Mqr1oo/GLYPH/.github/release/notes.md

## 🗺️ A detailed map of the whole world, and routes that go straight into GLYPH

### Download

**GLYPH-1.3.0.apk**: the Android app, for Android 7 or newer. Open it on your phone to install.

The app keeps itself up to date once it is installed. The GLYPH firmware (04.10.26) is inside it:
the app installs it over USB-C with the access code that comes with your GLYPH, and GLYPH then
updates itself over Wi-Fi from **Control › Firmware**.

### What's new

**Maps**
- A **detailed dark map of the whole world**: streets, hiking trails, forest tracks, peaks with their height, rivers, huts and borders.
- **Save area** keeps what you see for use with no signal. **Save for this route** keeps a 2 km band along your route.
- With no signal you still get a world map with towns, forests and borders.
- Places worldwide are found offline: every town and village with 500 people or more is built in.

**Routes**
- Bike and walking routes stay on land instead of taking a ferry.
- A smaller route panel that leaves the map in view.
- **Send to GLYPH** loads the route into the device's own memory, no card needed. The small card button saves it to the memory card only.

**Setup**
- **Install firmware over USB-C, straight from your phone**: the app's first screen, with your GLYPH access code. No computer, no internet.

**Look and feel**
- A cleaner Comms tab, a single "not connected" line in Control, the guided tour always on screen, and the map credits folded into a small **i**.

See the full [changelog](https://github.com/Mqr1oo/GLYPH/blob/main/CHANGELOG.md).

### Checksums

`SHA256SUMS.txt` lists the SHA-256 of every file in this release.
