Mqr1oo/GLYPH/docs/GLYPH-build-guide.pdf

# GLYPH

# Build guide

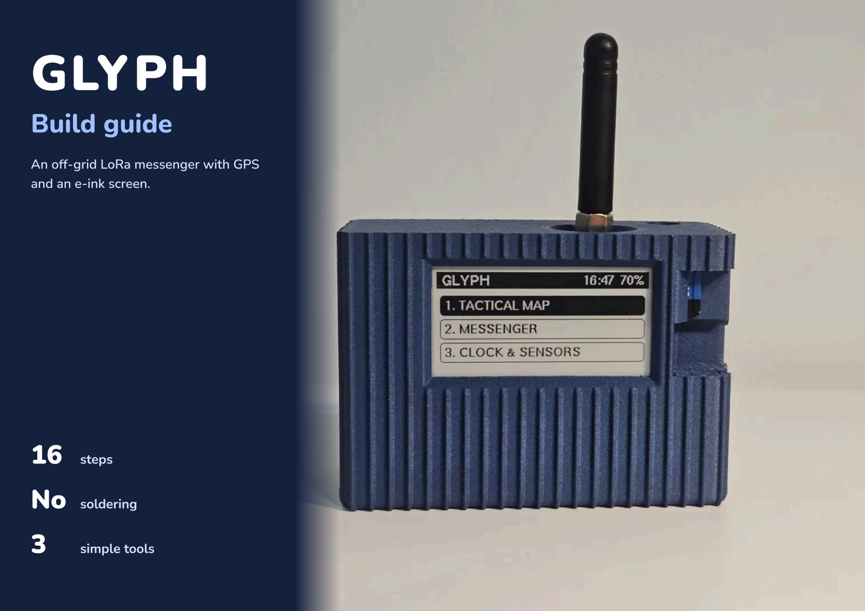
[picture p13: page 1]

An off-grid LoRa messenger with GPS and an e-ink screen.

16 steps

No soldering

3 simple tools

# ! Before you start

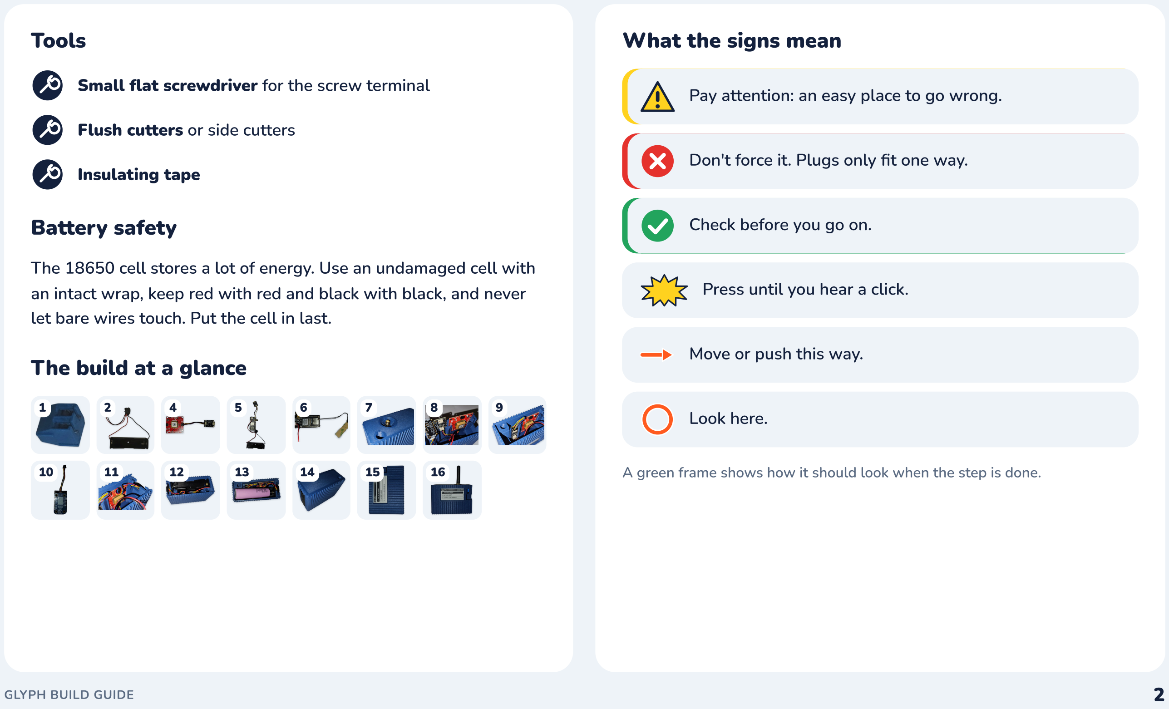
[picture p14: figure]
Tools; Flush cutters or side cutters; Insulating tape; Battery safety; The build at a glance; What the signs mean; Don't force it. Plugs only fit one way.; Check before you go on.; Press until you hear a click.; Move or push this way.; Look here.; GLYPH BUILD GUIDE

Small flat screwdriver for the screw terminal

The 18650 cell stores a lot of energy. Use an undamaged cell with an intact wrap, keep red with red and black with black, and never let bare wires touch. Put the cell in last.

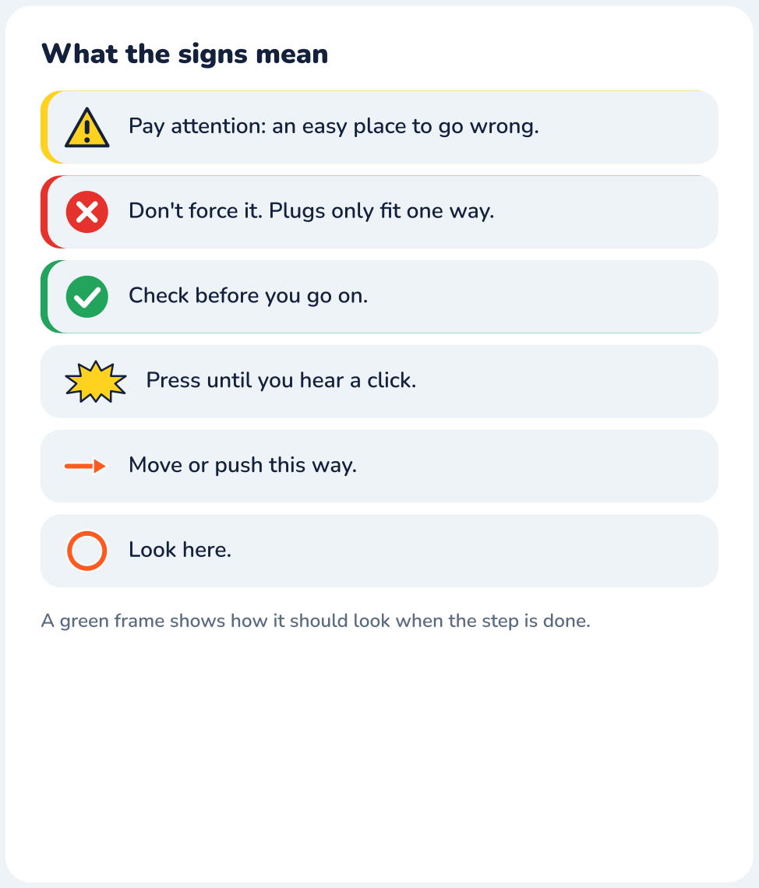
[picture p15: figure]

Pay attention: an easy place to go wrong.

A green frame shows how it should look when the step is done.

# ☰ Parts

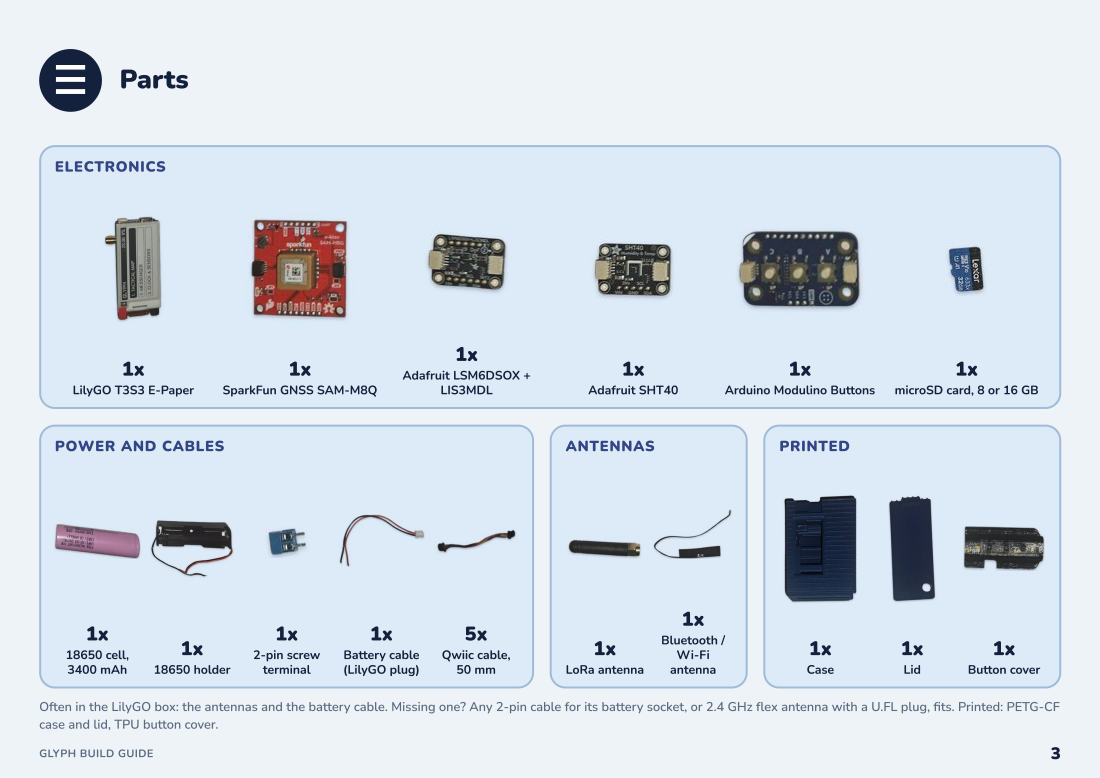
[picture p16: page 3]
ELECTRONICS; LilyGO T3S3 E-Paper; Adafruit LSM6DSOX + LIS3MDL; Adafruit SHT40; 18650 cell, 3400 mAh; 18650 holder; 2-pin screw terminal; Battery cable (LilyGO plug); Qwiic cable, 50 mm; ANTENNAS; LoRa antenna; Bluetooth / Wi-Fi antenna; PRINTED; Case; Lid; Button cover

SparkFun GNSS SAM-M8Q

Arduino Modulino Buttons

microSD card, 8 or 16 GB

POWER AND CABLES

Often in the LilyGO box: the antennas and the battery cable. Missing one? Any 2-pin cable for its battery socket, or 2.4 GHz flex antenna with a U.FL plug, fits. Printed: PETG-CF
case and lid, TPU button cover.

# ⚙ Print the parts

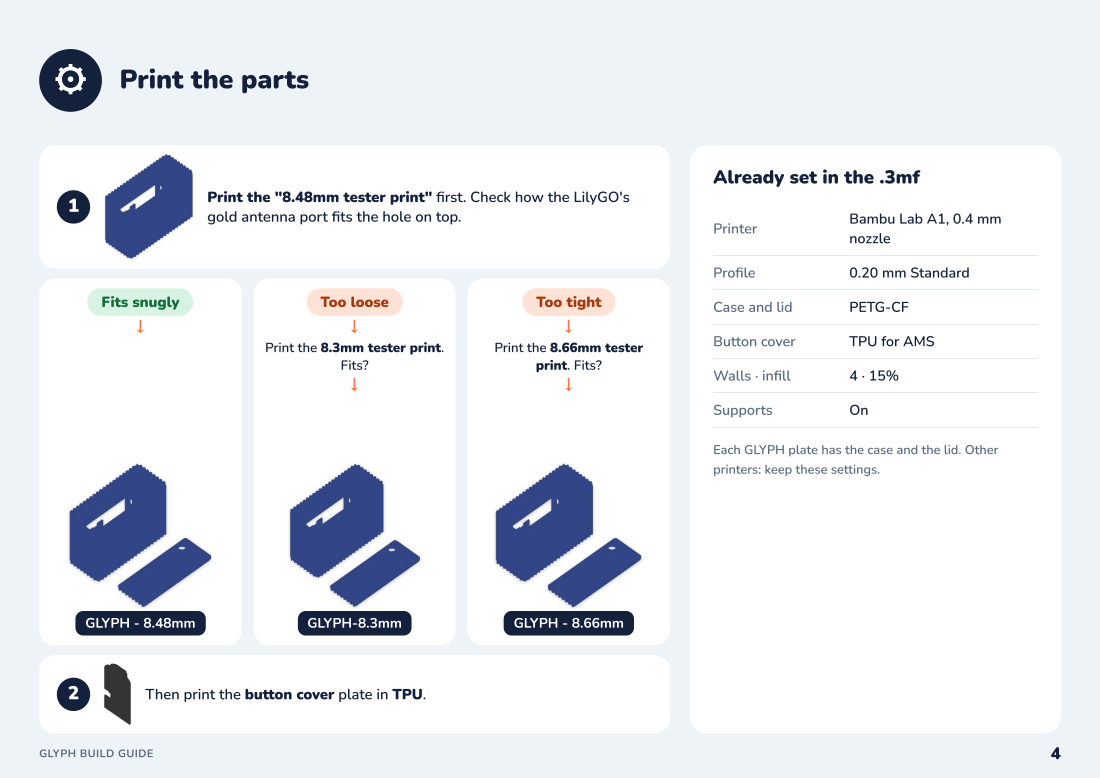
[picture p17: page 4]
Fits snugly ↓; GLYPH - 8.48mm; Too loose ↓; Fits? ↓; GLYPH-8.3mm; Too tight ↓; print. Fits?; GLYPH - 8.66mm; Then print the button cover plate in TPU.; Printer; Profile; 0.20 mm Standard; Case and lid; PETG-CF; Button cover; TPU for AMS; Walls · infill; Supports

Already set in the .3mf

Print the "8.48mm tester print" first. Check how the LilyGO's
gold antenna port fits the hole on top.

Bambu Lab A1, 0.4 mm
nozzle

Print the 8.3mm tester print.

Print the 8.66mm tester

Each GLYPH plate has the case and the lid. Other
printers: keep these settings.

# 1 Trim the screw terminal

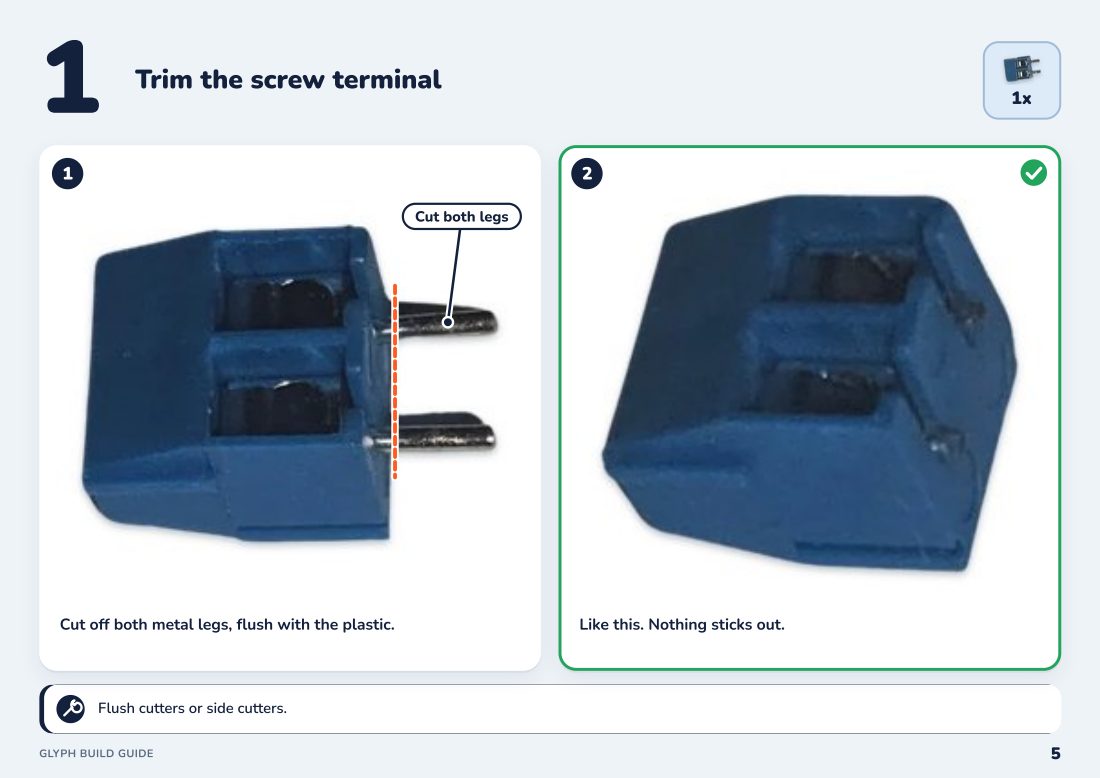
[picture p18: page 5]
Cut off both metal legs, flush with the plastic.; Like this. Nothing sticks out.

Cut both legs

Flush cutters or side cutters.

# 2 Wire the battery holder

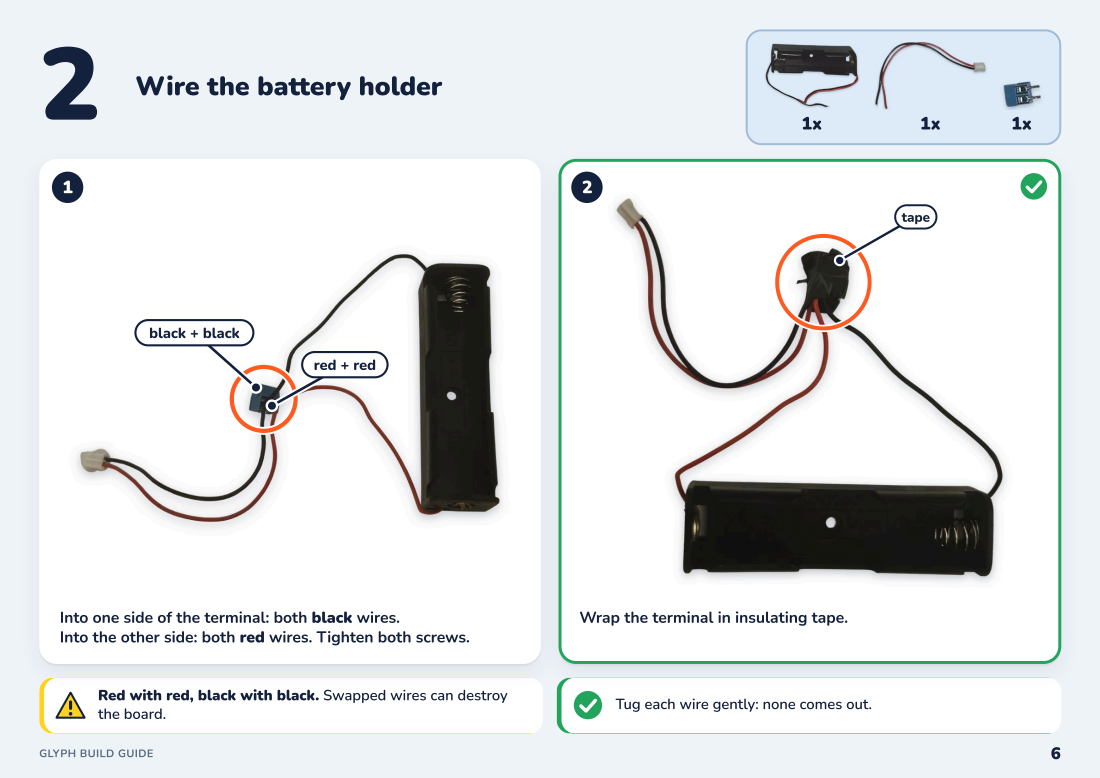
[picture p19: page 6]
black + black; red + red; tape

Into one side of the terminal: both black wires.
Into the other side: both red wires. Tighten both screws.

Wrap the terminal in insulating tape.

Red with red, black with black. Swapped wires can destroy
the board.

Tug each wire gently: none comes out.

3

# Plug the battery into the

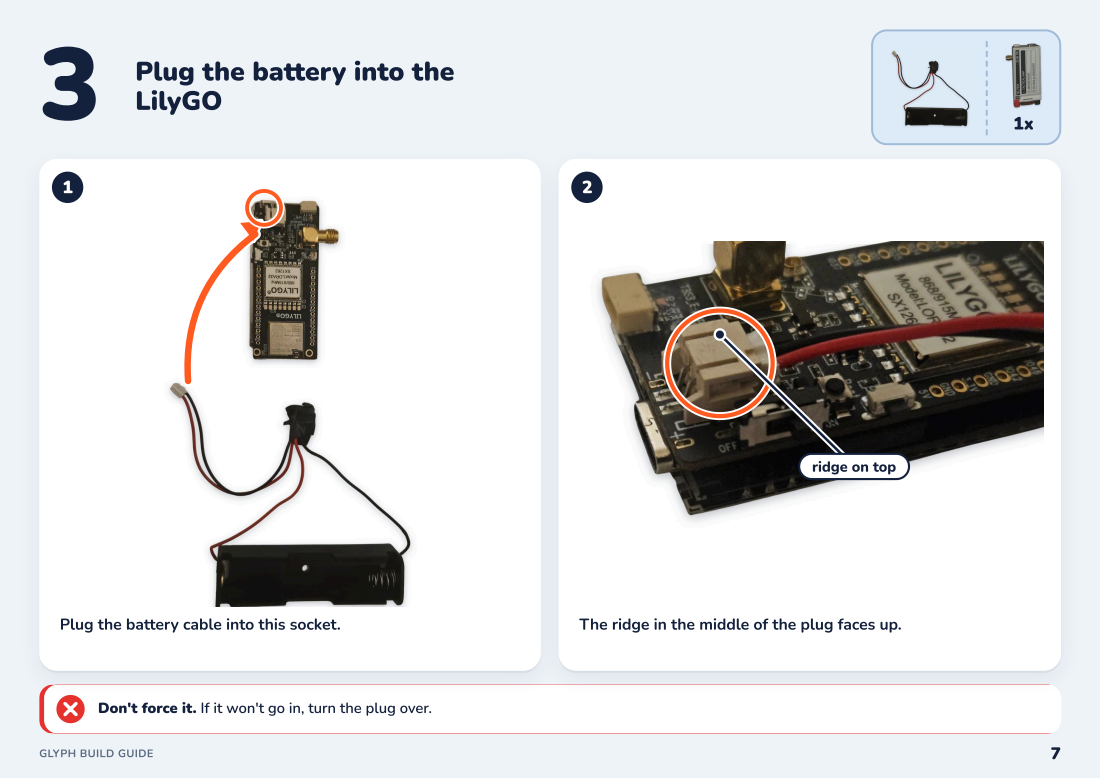
[picture p20: page 7]
LilyGO

ridge on top

Plug the battery cable into this socket.

The ridge in the middle of the plug faces up.

Don't force it. If it won't go in, turn the plug over.

4

# Join the GPS and the

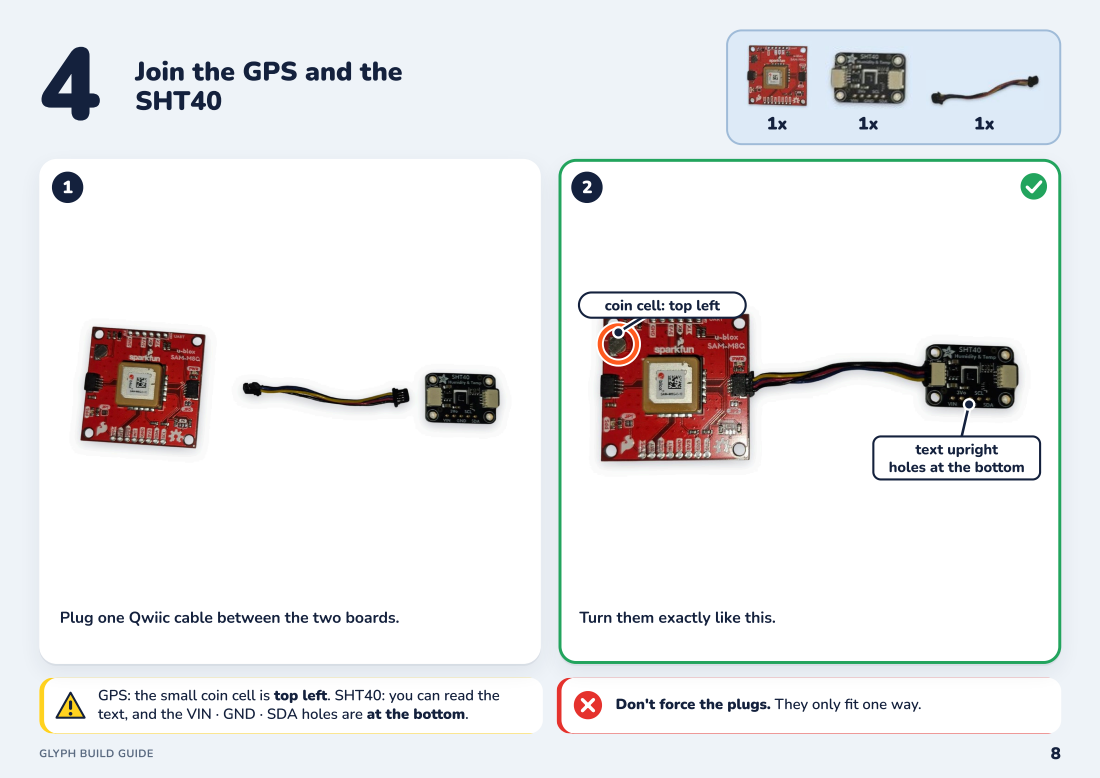
[picture p21: page 8]
SHT40

coin cell: top left

text upright
holes at the bottom

Plug one Qwiic cable between the two boards.

Turn them exactly like this.

GPS: the small coin cell is top left. SHT40: you can read the
text, and the VIN · GND · SDA holes are at the bottom.

Don't force the plugs. They only fit one way.

# 5 Connect the IMU

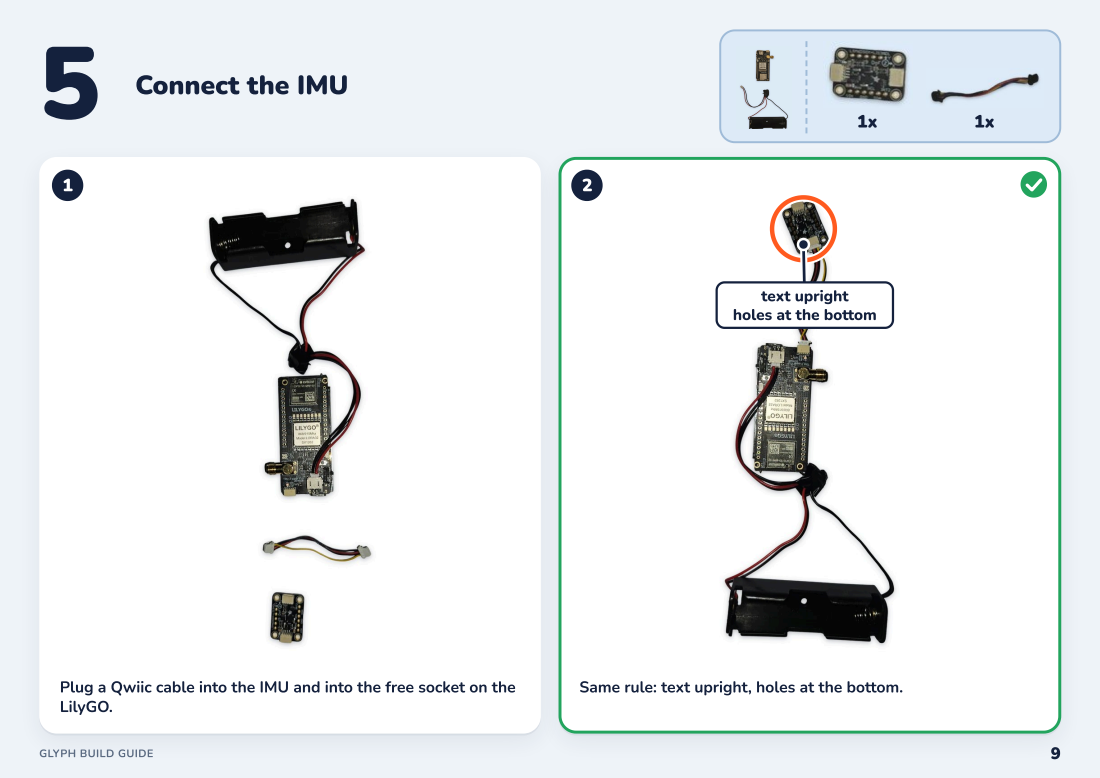
[picture p22: page 9]

text upright
holes at the bottom

Plug a Qwiic cable into the IMU and into the free socket on the
LilyGO.

Same rule: text upright, holes at the bottom.

6

# Fit the Bluetooth / Wi-Fi

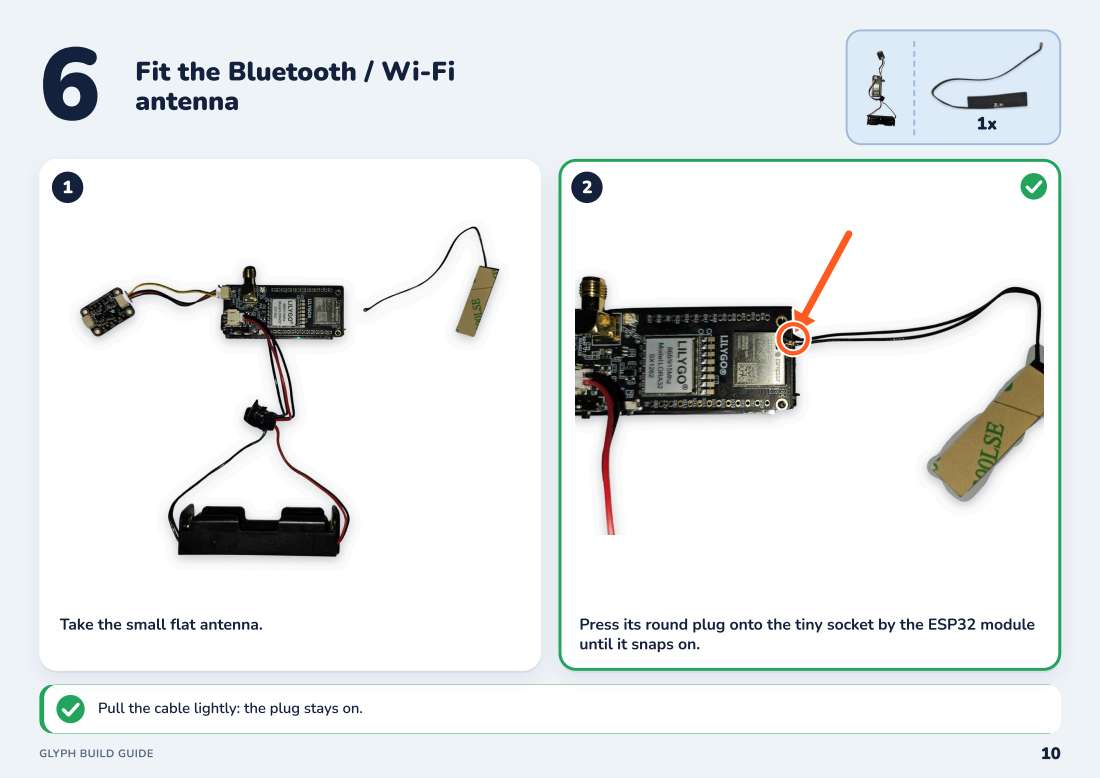
[picture p23: page 10]
antenna; Take the small flat antenna.; Press its round plug onto the tiny socket by the ESP32 module

until it snaps on.

Pull the cable lightly: the plug stays on.

# 7 Put the board in the case

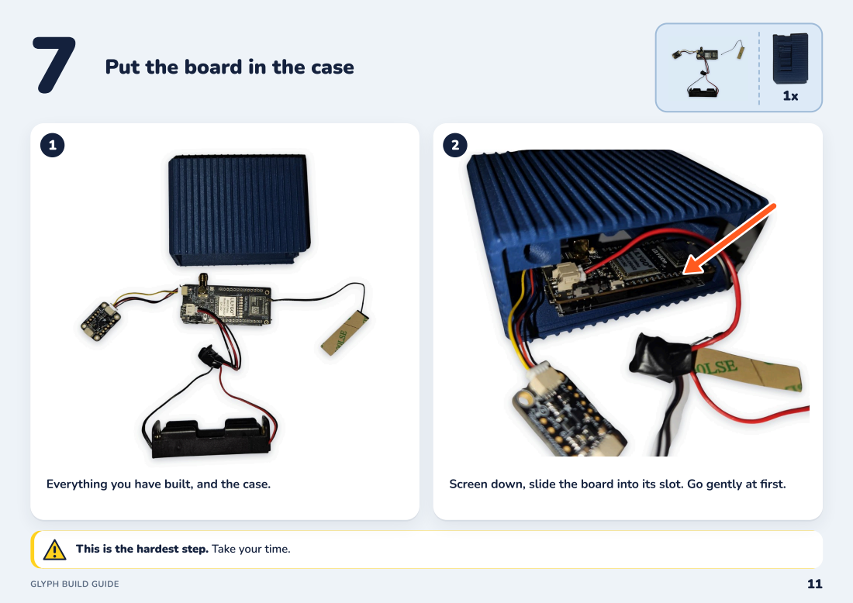
[picture p24: page 11]
Everything you have built, and the case.; Screen down, slide the board into its slot. Go gently at first.

This is the hardest step. Take your time.

7

# Put the board in the case

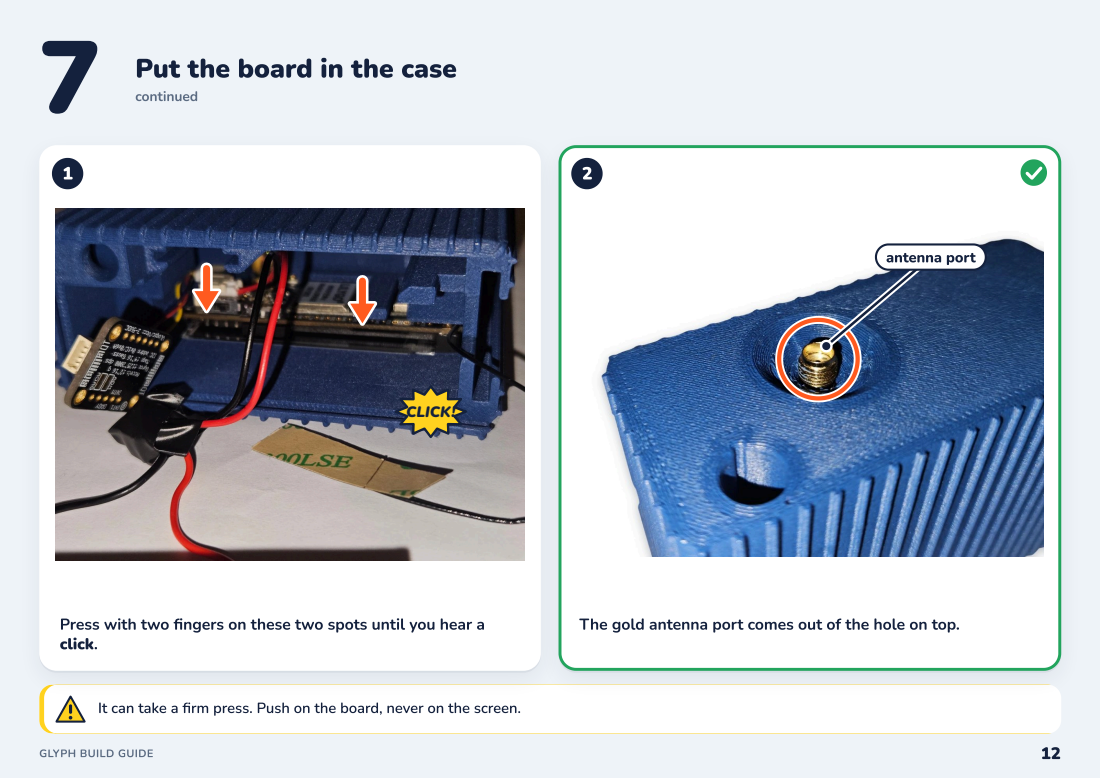
[picture p25: page 12]
continued; CLICK!; antenna port

Press with two fingers on these two spots until you hear a
click.

The gold antenna port comes out of the hole on top.

It can take a firm press. Push on the board, never on the screen.

8

# Place the GPS and the

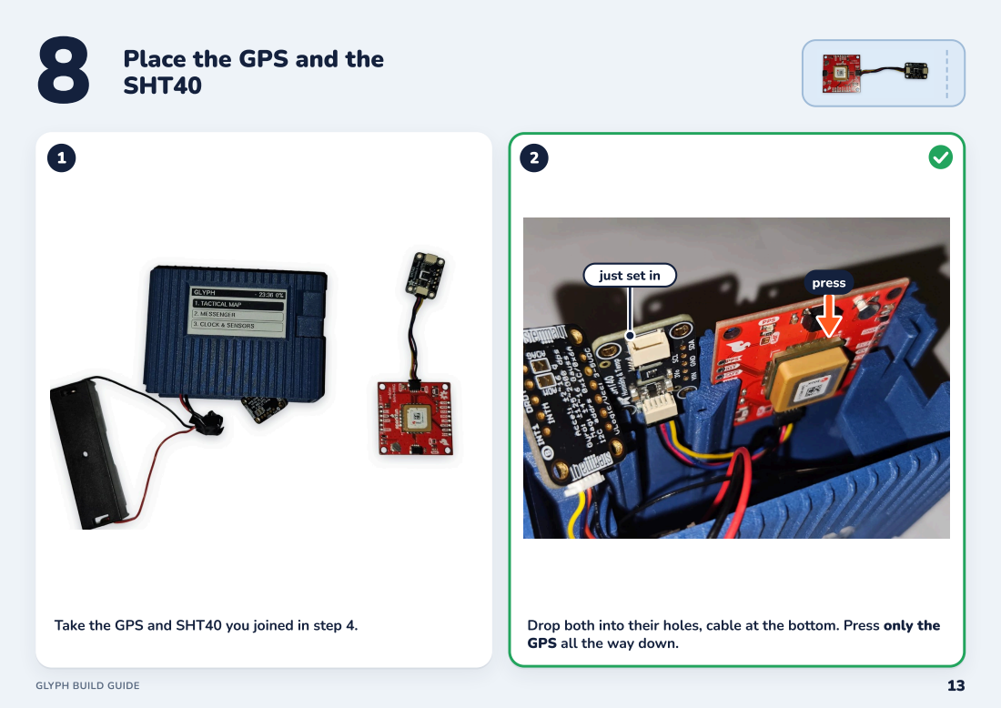
[picture p26: page 13]
SHT40; press

just set in

Take the GPS and SHT40 you joined in step 4.

Drop both into their holes, cable at the bottom. Press only the
GPS all the way down.

9

# Connect the SHT40 to the

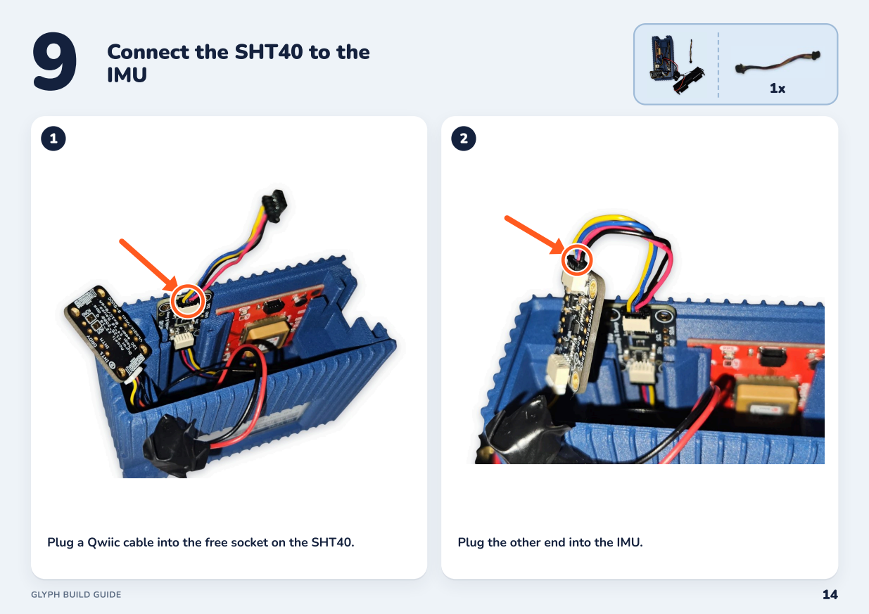
[picture p27: page 14]
IMU; Plug a Qwiic cable into the free socket on the SHT40.; Plug the other end into the IMU.

9

# Connect the SHT40 to the

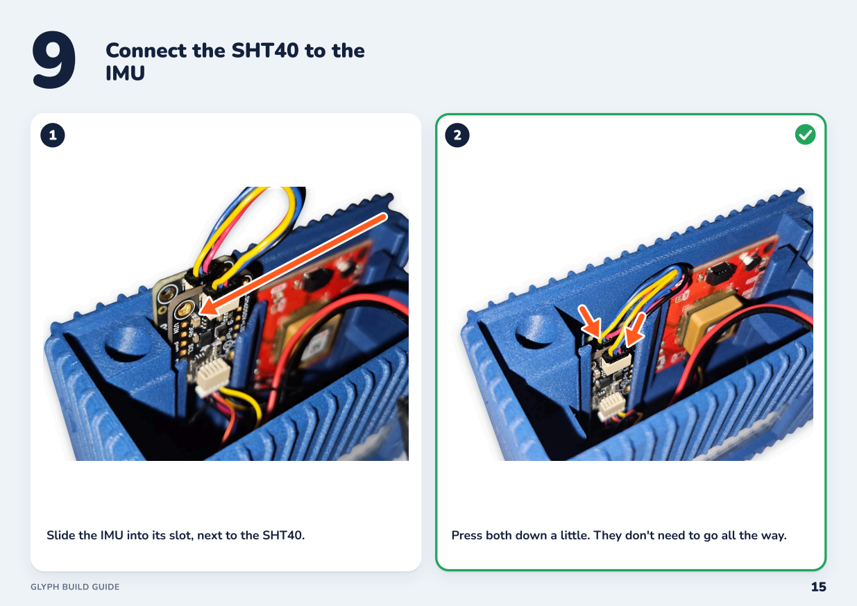
[picture p28: page 15]
IMU; Slide the IMU into its slot, next to the SHT40.; Press both down a little. They don't need to go all the way.

# 10 Build the buttons

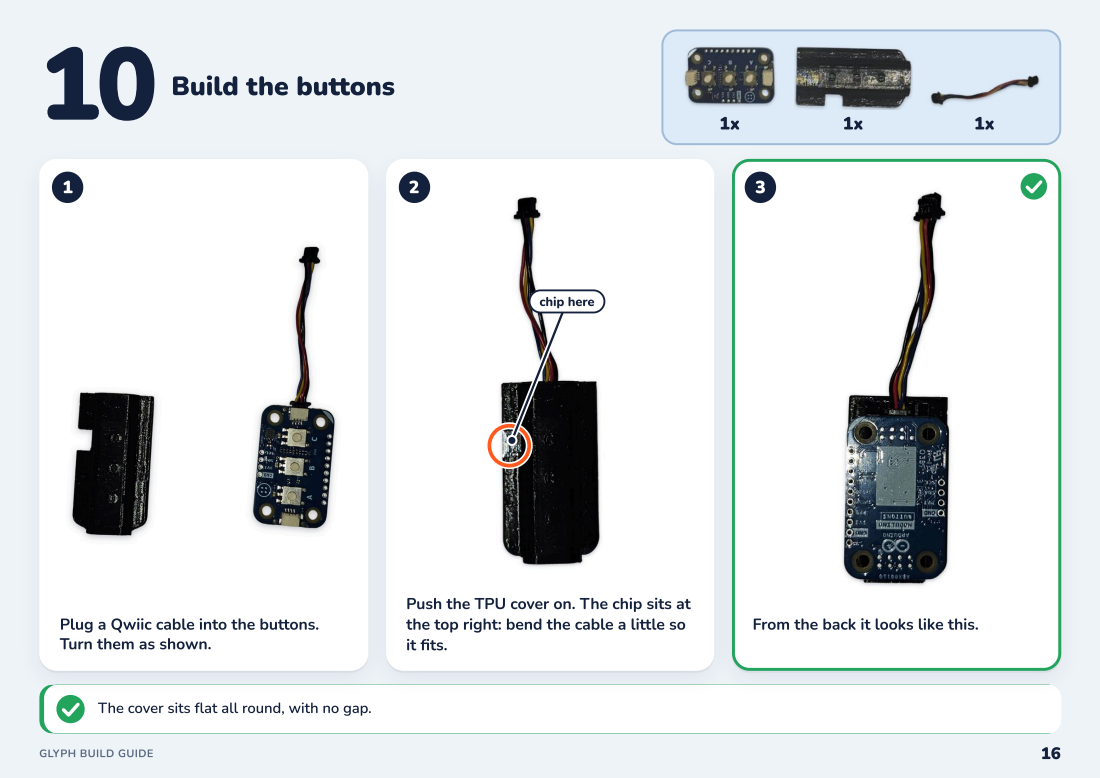
[picture p29: page 16]
chip here

Push the TPU cover on. The chip sits at
the top right: bend the cable a little so
it fits.

Plug a Qwiic cable into the buttons.
Turn them as shown.

From the back it looks like this.

The cover sits flat all round, with no gap.

# 11Fit the buttons

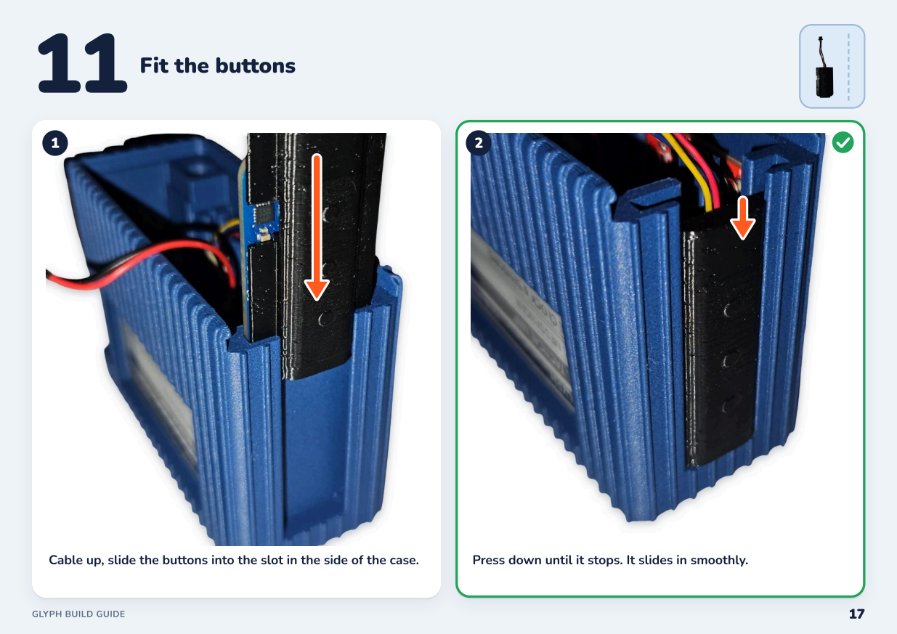
[picture p30: page 17]
Cable up, slide the buttons into the slot in the side of the case.; Press down until it stops. It slides in smoothly.

11

# Fit the buttons

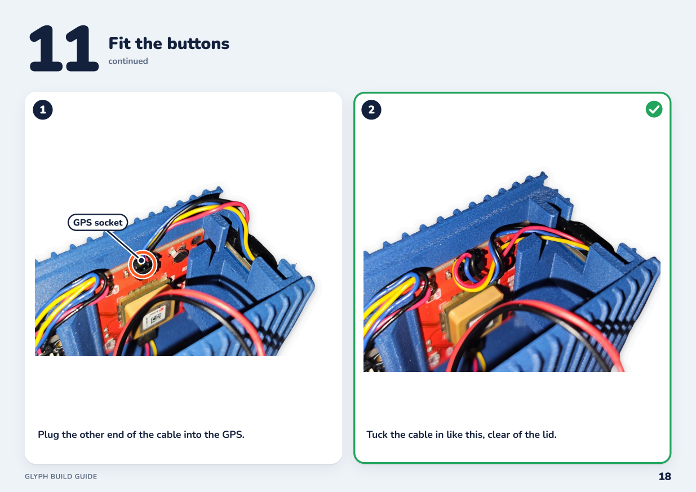
[picture p31: page 18]
continued; GPS socket; Plug the other end of the cable into the GPS.; Tuck the cable in like this, clear of the lid.

# 12Fit the battery holder

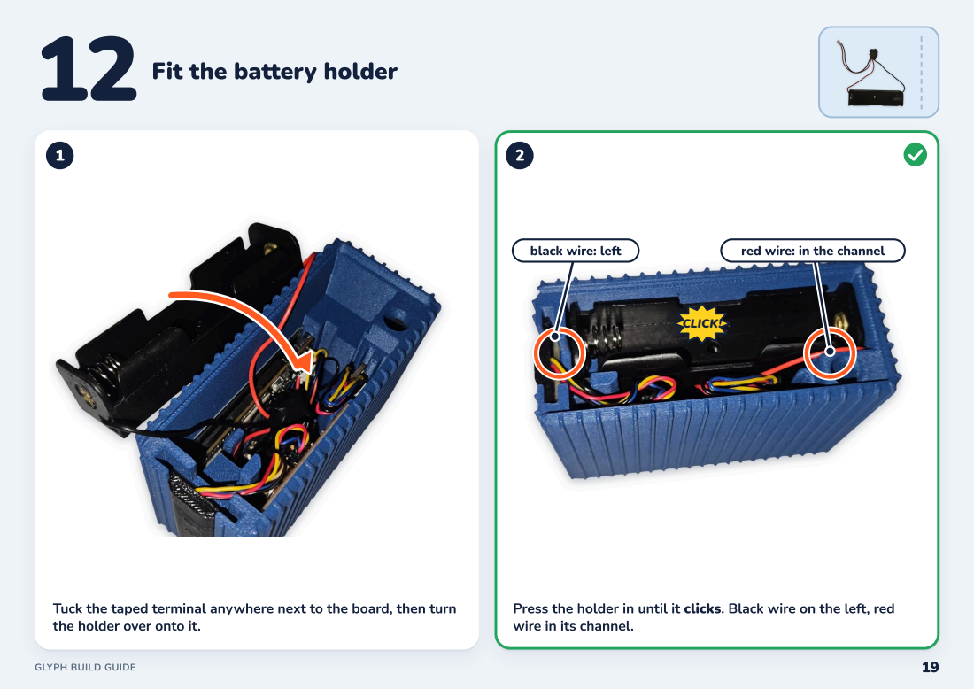
[picture p32: page 19]
black wire: left; red wire: in the channel; CLICK!

Tuck the taped terminal anywhere next to the board, then turn
the holder over onto it.

Press the holder in until it clicks. Black wire on the left, red
wire in its channel.

# 13Insert the battery

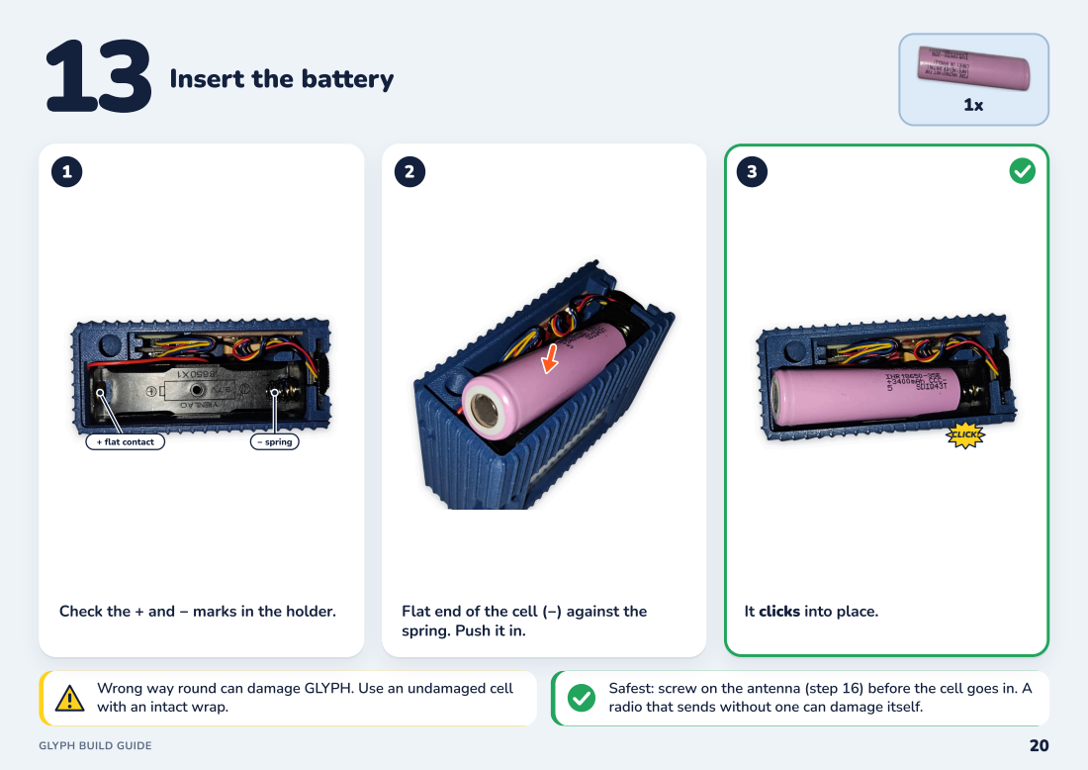
[picture p33: page 20]
+ flat contact; − spring; Check the + and − marks in the holder.; Flat end of the cell (−) against the; CLICK!

It clicks into place.

spring. Push it in.

Wrong way round can damage GLYPH. Use an undamaged cell
with an intact wrap.

Safest: screw on the antenna (step 16) before the cell goes in. A
radio that sends without one can damage itself.

# 14 Close the lid

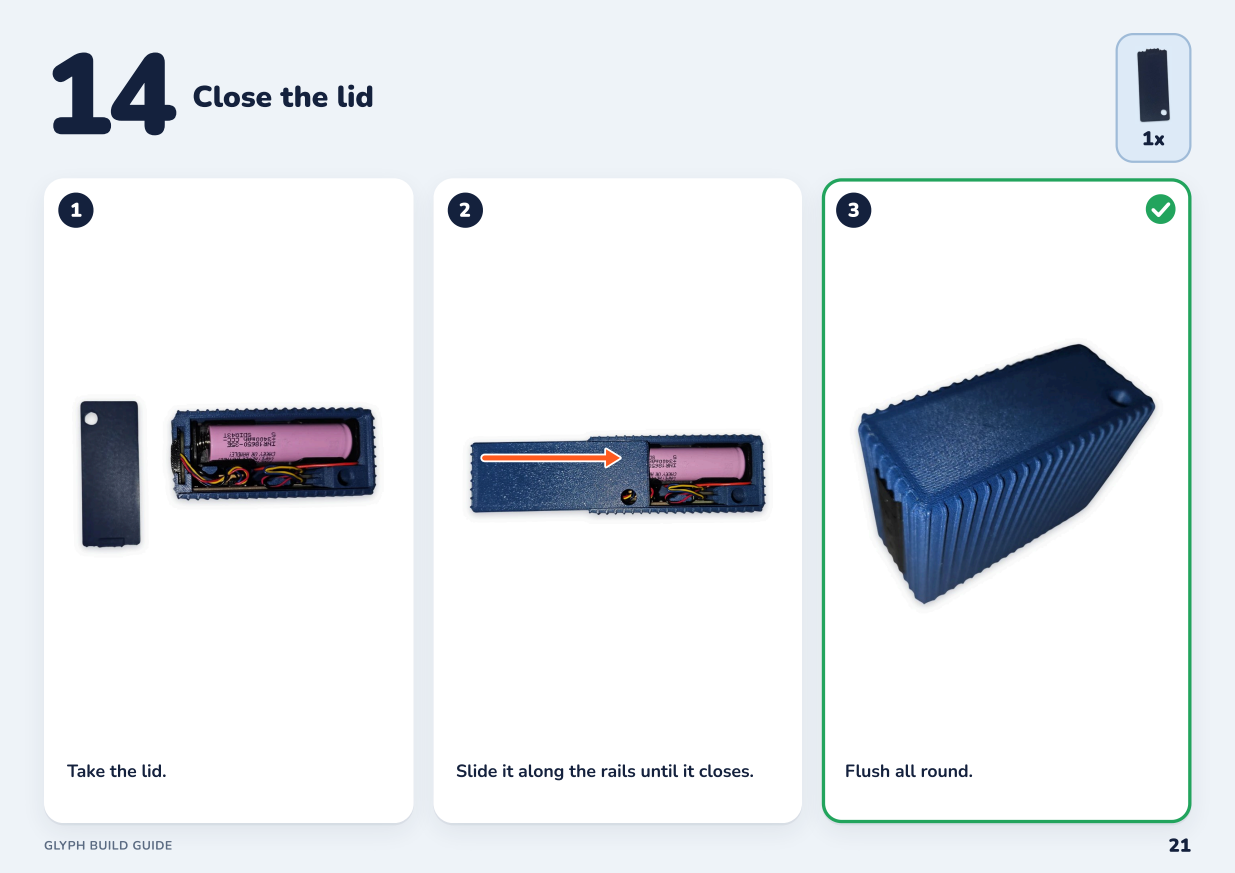
[picture p34: page 21]
Take the lid.; Slide it along the rails until it closes.; Flush all round.

# 15Insert the microSD card

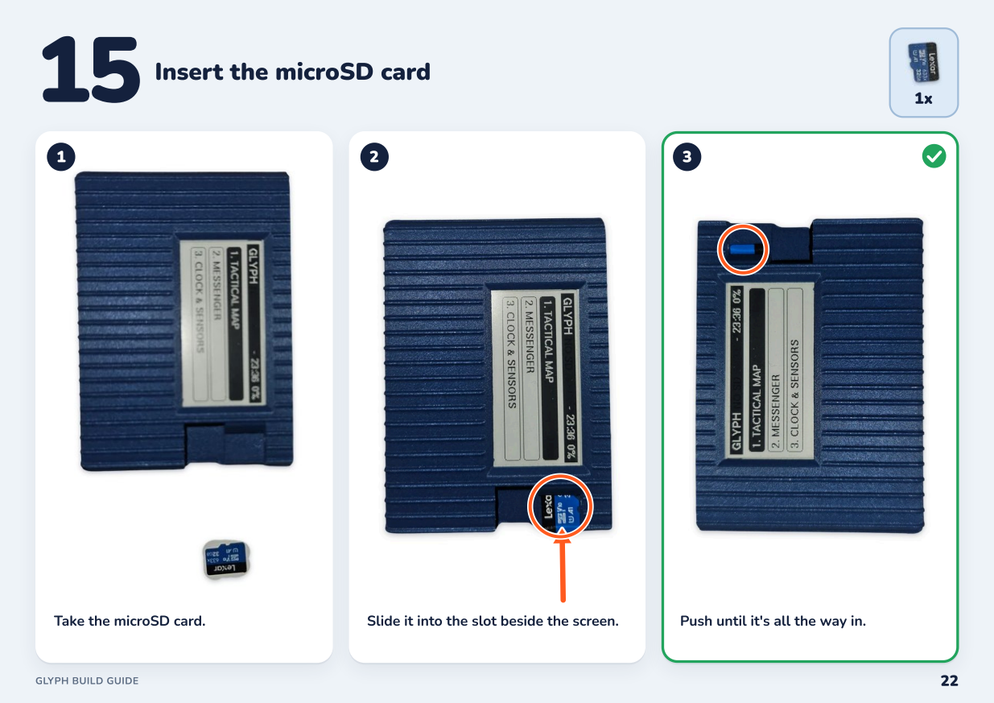
[picture p35: page 22]
Take the microSD card.; Slide it into the slot beside the screen.; Push until it's all the way in.

# 16 Screw on the antenna

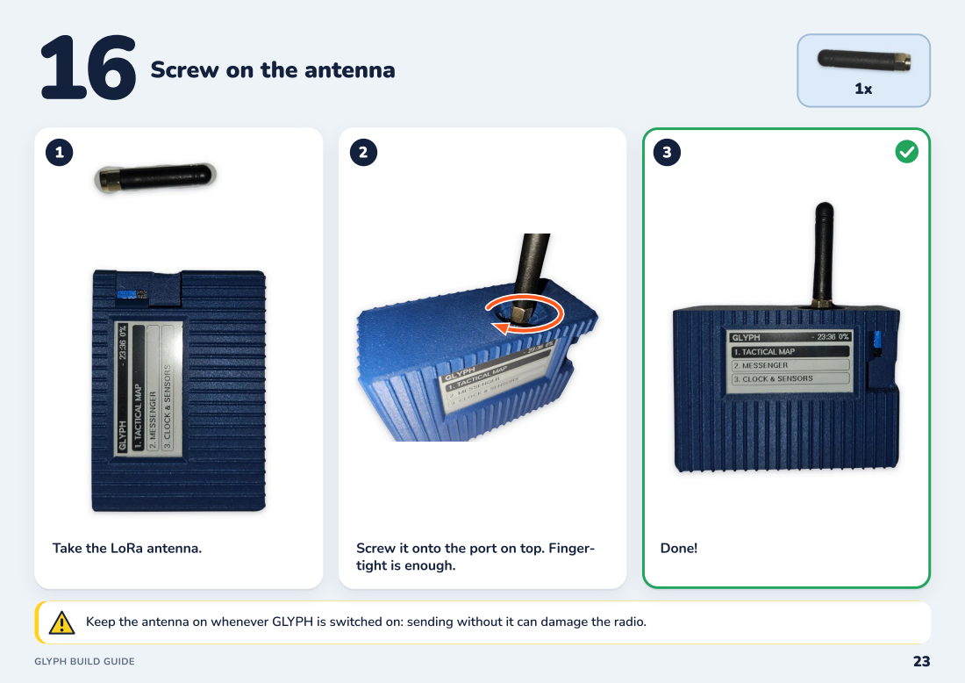
[picture p36: page 23]
Take the LoRa antenna.; Screw it onto the port on top. Finger-; Done!

tight is enough.

Keep the antenna on whenever GLYPH is switched on: sending without it can damage the radio.

# ✓ Your GLYPH is built

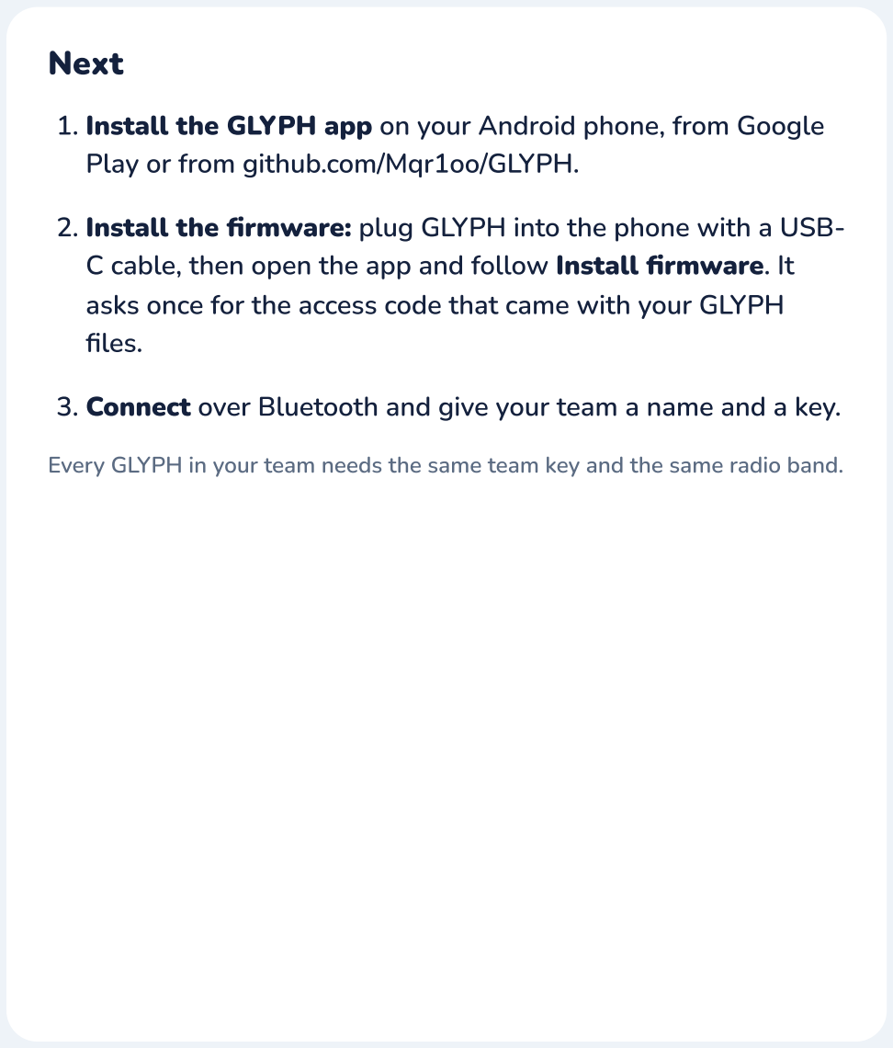
[picture p37: figure]
Next; Play or from github.com/Mqr1oo/GLYPH.; files.
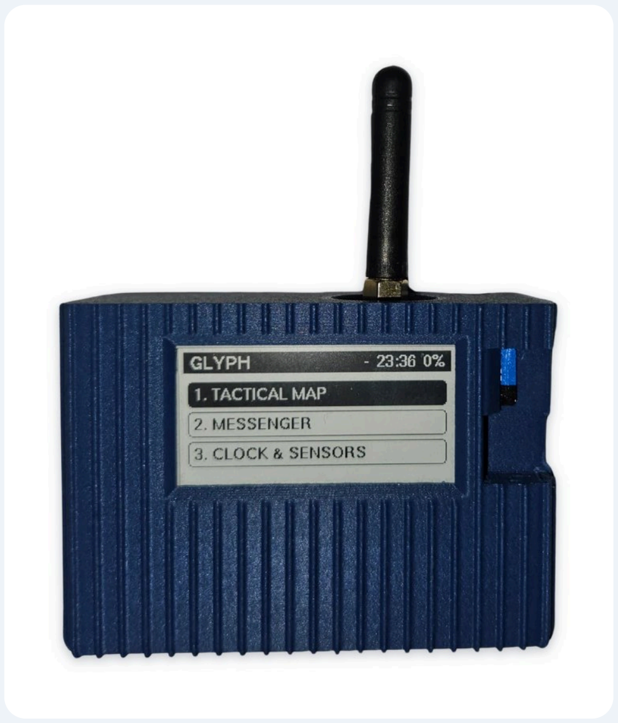
[picture p38: figure]

1. Install the GLYPH app on your Android phone, from Google
2. Install the firmware: plug GLYPH into the phone with a USB-C cable, then open the app and follow Install firmware. It asks once for the access code that came with your GLYPH
3. Connect over Bluetooth and give your team a name and a key.

Every GLYPH in your team needs the same team key and the same radio band.
