Mqr1oo/GLYPH/(commit log)

2026-03-31 Rename GLYPH.ino to Arduino files/GLYPH.ino
2026-10-04 Release 1.3.0: the Android app and firmware 04.10.26
    A workflow downloads both from where they are built, checks their
    SHA-256 and attaches them to the GitHub release.
2026-10-04 One home for GLYPH: app, firmware, hardware, diagnostic and guide
    The firmware is no longer offered for download here: it comes with a
    GLYPH and the app installs it with the access code. The release keeps
    only the app, and links to the computer flasher are gone. The privacy
    policy, a user guide, hardware notes and issue forms are new; the
    diagnostic sketch moves to diagnostic/.
    [GLYPH_Diagnostic.ino]
2026-10-05 Build guide: 16 illustrated steps, from the tester print to the antenna
2026-10-05 Build guide: what to buy if the LilyGO box has no flat antenna or battery cable
